MFKMOR011/Acoustic-Direction-Finding-System/ccad/bottom-mfkmor011.stl

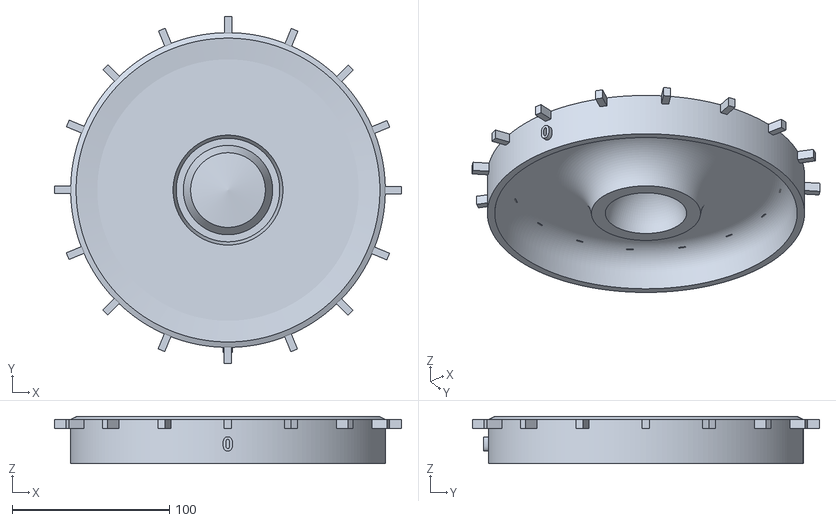
[picture p59: CAD file, 2026-10-28]
ccad/bottom-mfkmor011.stl
220.5 x 220.5 x 29.9
