MFKMOR011/Acoustic-Direction-Finding-System/ccad/top-mfkmor011.stl

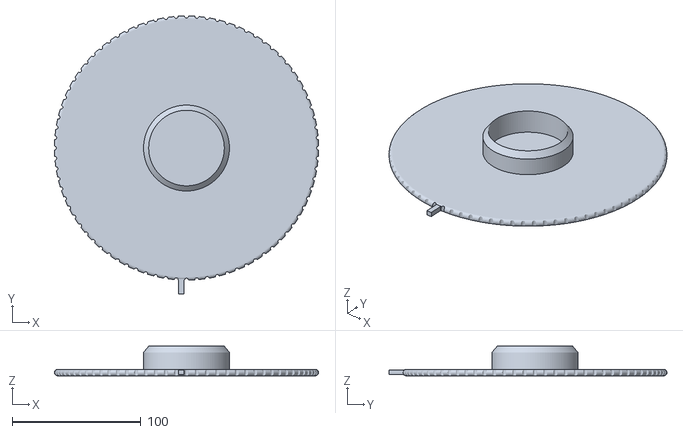
[picture p60: CAD file, 2026-10-28]
ccad/top-mfkmor011.stl
205.0 x 215.8 x 23.0
