MFKMOR011/Acoustic-Direction-Finding-System/ccad/Housing.stl

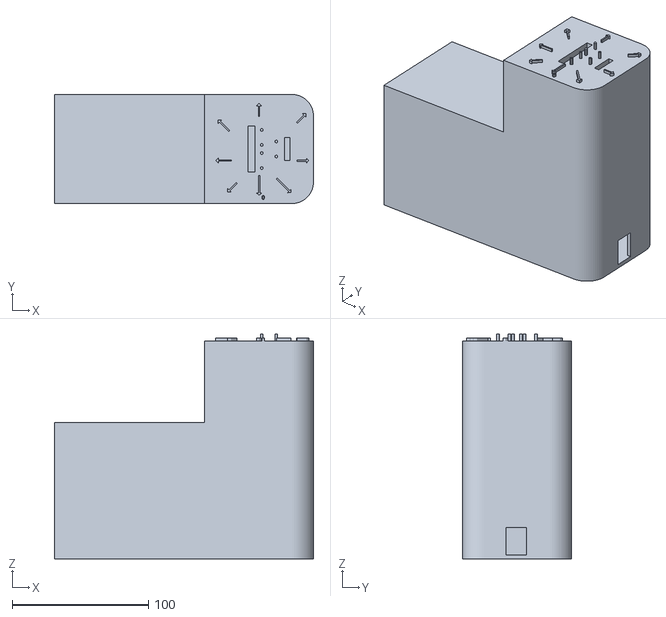
[picture p61: CAD file, 2026-10-28]
ccad/Housing.stl
190.0 x 80.0 x 165.0
