MFKMOR011/Acoustic-Direction-Finding-System/docs/DOA RESULTS (1).xlsx

 |  |  |  |  |  |  | Absolute Circular Error
Platform | Algorithm | Signal | Distance (cm) | True angle | Measured angle |  | Angle Error | Average Errors | Squared Error | Tets 2 | Test 3 | Test 4 | Test 5 | Test 6 | MAE | RMSE | Bias | SD | CI 95%
Simu;ation | MUSIC | 4kHz Sine | - | 0 | 359.9 |  | 0.1 |  | 0.01 | 359.34 | 359.215 | 359.724 | 360.873 | 361.373 | 0.01666666667 | 0.04082482905 | -0.01666666667 | 0.04082482905 | -0.02 ± 0.03
Simu;ation | MUSIC |  | - | 22.5 | 22.5 |  | 0 |  | 0 | 23.696 | 22.128 | 21.879 | 22.657 | 22.61
Simu;ation | MUSIC |  | - | 45 | 45 |  | 0 |  | 0 | 44.122 | 45.306 | 45.213 | 45.85 | 46.039
Simu;ation | MUSIC |  | - | 90 | 90 |  | 0 |  | 0 | 89.899 | 90.008 | 91.134 | 90.213 | 88.872
Simu;ation | MUSIC |  | - | 180 | 180 |  | 0 | 0.01666666667 | 0 | 180.426 | 180.265 | 178.519 | 179.07 | 179.194
Simu;ation | MUSIC |  | - | 270 | 270 |  | 0 |  | 0 | 270.459 | 268.718 | 269.107 | 269.614 | 268.828
Platform | Algorithm | Signal | Distance (cm) | True angle | Measured angle |  | Angle error
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
